airpocket-soundman/yashica8/img/yashica8T_PCB.png

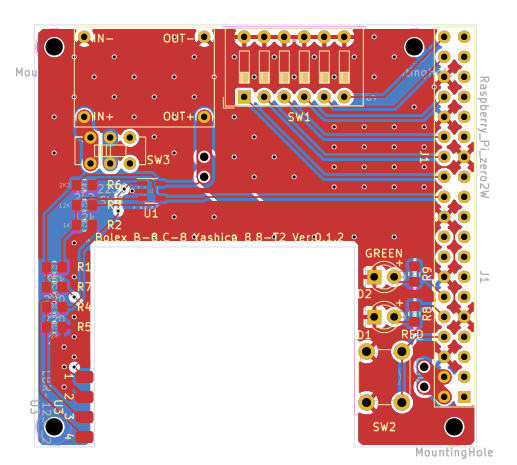
img/yashica8T_PCB.png
