airpocket-soundman/yashica8/img/yashica8T_schematic.png

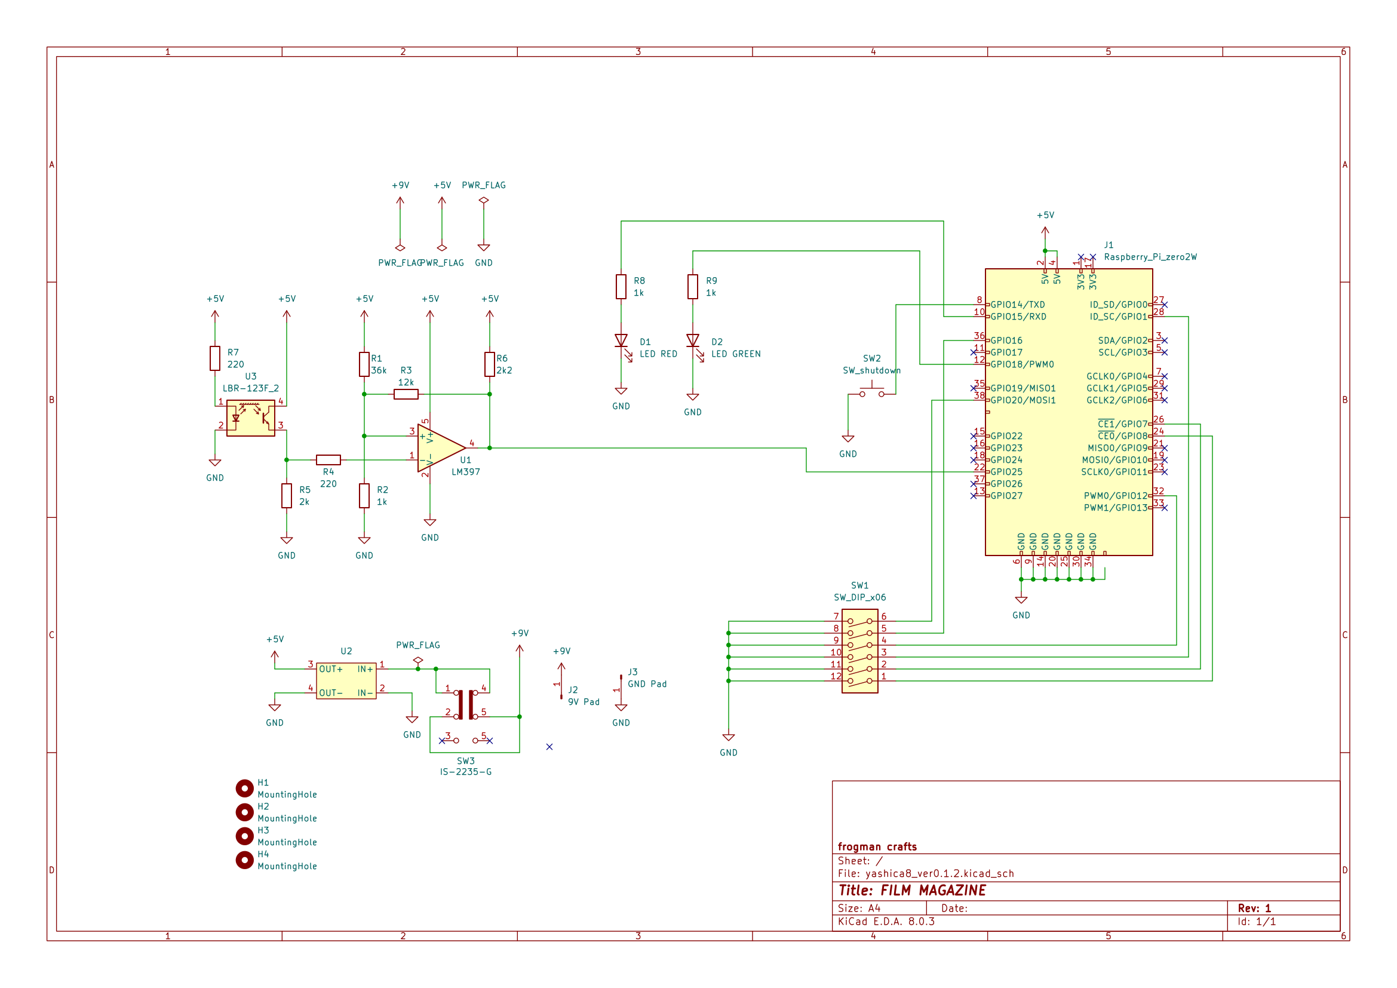
img/yashica8T_schematic.png
