airpocket-soundman/yashica8/stl/film_guide_yashica8 v12.stl

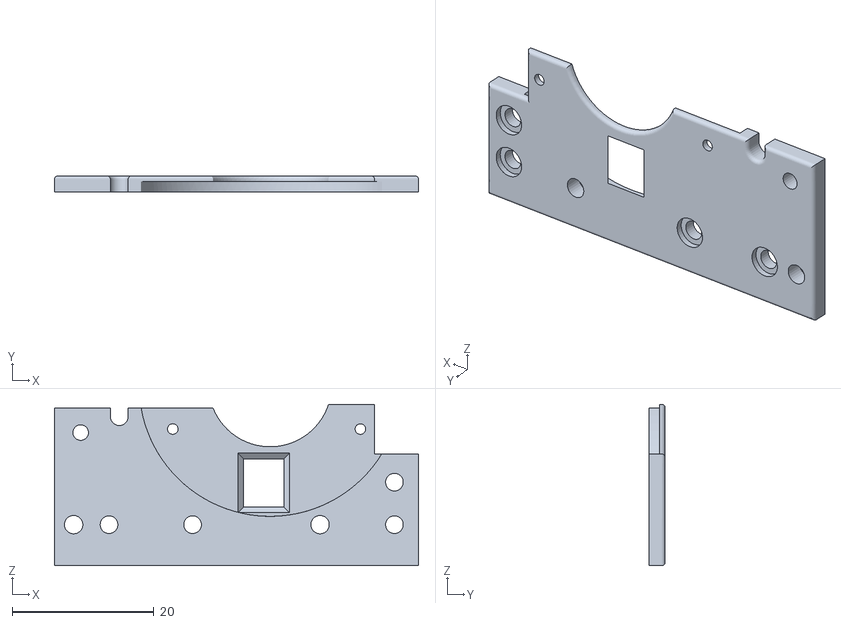
[picture p3: CAD file, 2024-09-23]
stl/film_guide_yashica8 v12.stl
51.4 x 2.30 x 22.8
