airpocket-soundman/yashica8/stl/floor_panel_yashica v19.stl

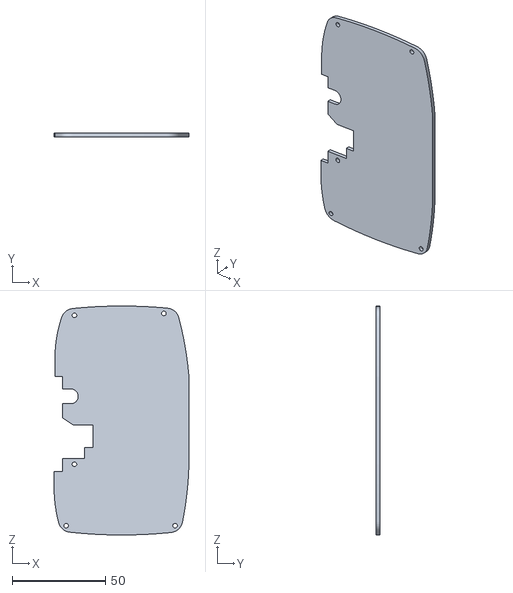
[picture p4: CAD file, 2024-09-23]
stl/floor_panel_yashica v19.stl
72.5 x 2.00 x 123.0
