airpocket-soundman/yashica8/stl/reflector_yashica8 v7.stl

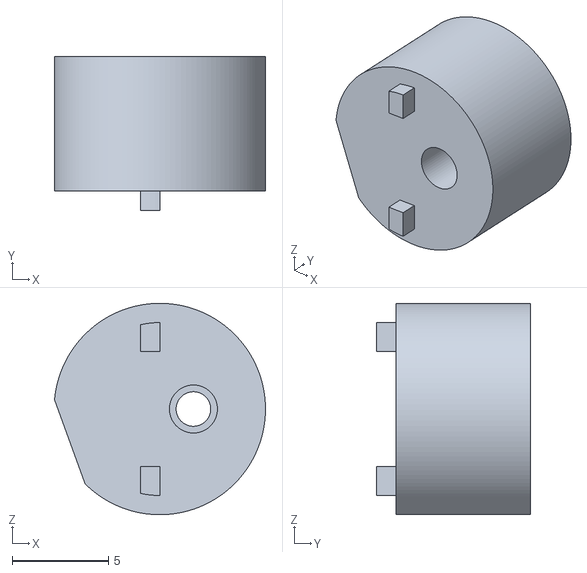
[picture p5: CAD file, 2024-09-23]
stl/reflector_yashica8 v7.stl
11.0 x 8.00 x 11.0
