airpocket-soundman/yashica8/stl/reflector_yashica8_T2 v8.stl

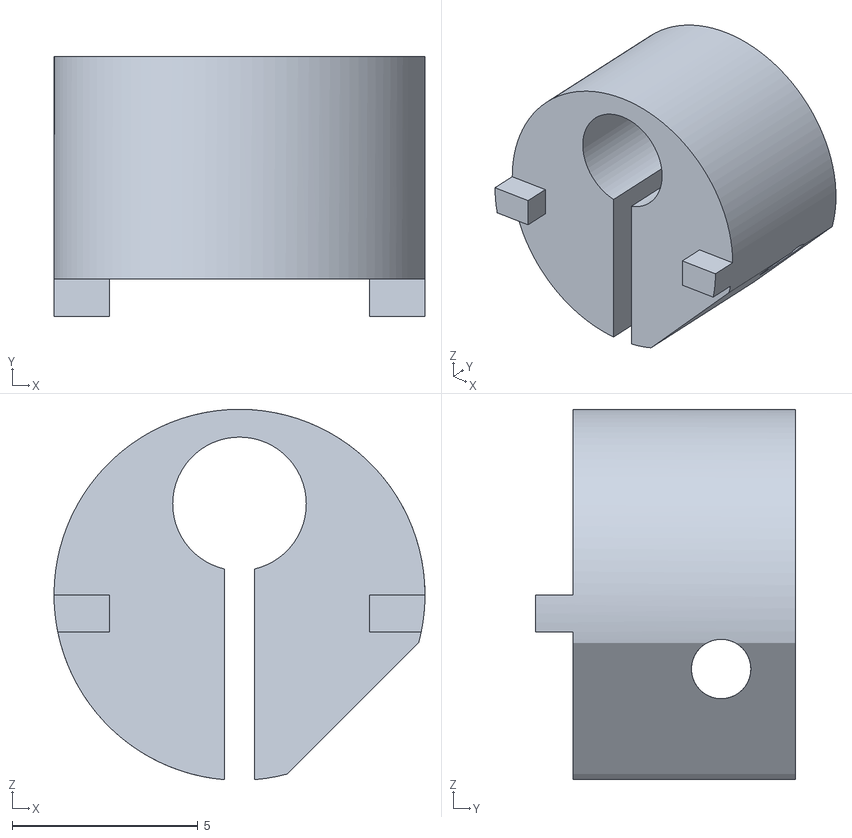
[picture p6: CAD file, 2024-09-23]
stl/reflector_yashica8_T2 v8.stl
10.0 x 7.00 x 9.98
