airpocket-soundman/yashica8/stl/base_pcb対応 v3.stl

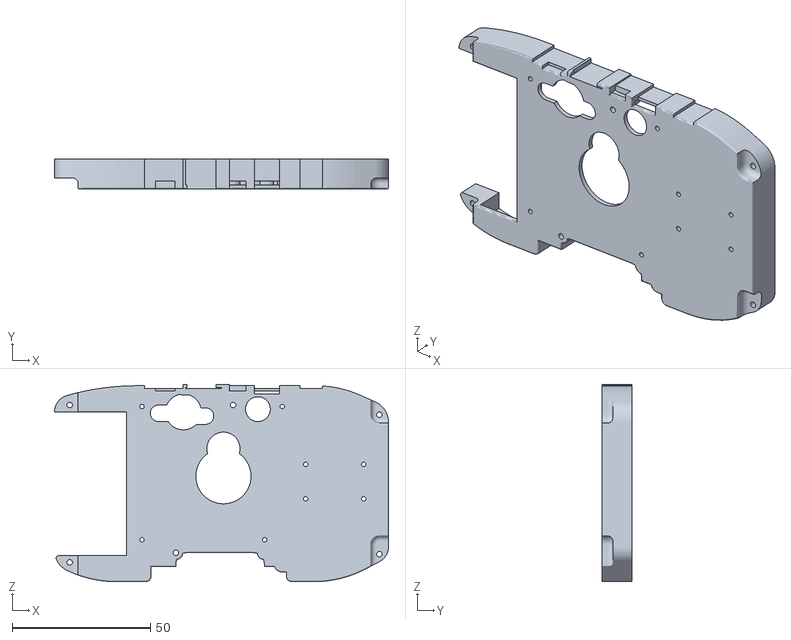
[picture p7: CAD file, 2024-09-23]
stl/base_pcb対応 v3.stl
121.0 x 11.0 x 71.5
