airpocket-soundman/yashica8/stl/top_pcb対応 v11.stl

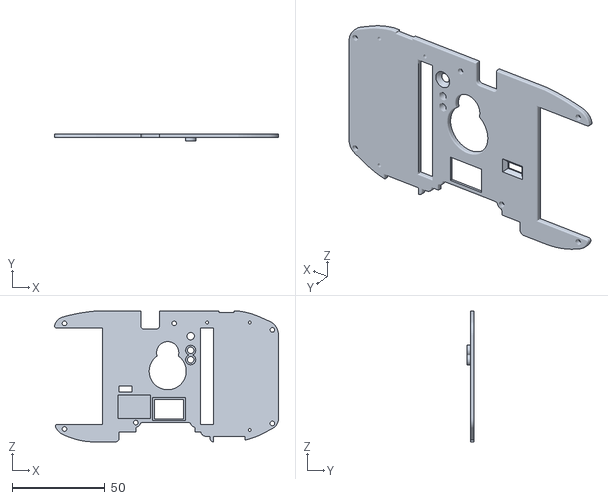
[picture p8: CAD file, 2024-09-23]
stl/top_pcb対応 v11.stl
120.9 x 4.00 x 70.7
