airpocket-soundman/yashica8/stl/film_guide_yashica8-T2 v3.stl

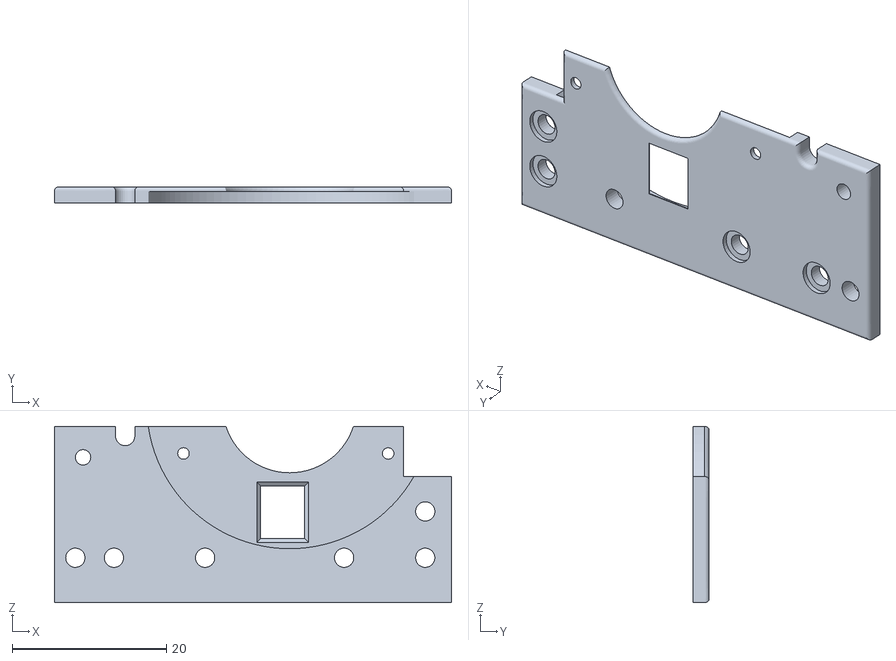
[picture p9: CAD file, 2024-09-23]
stl/film_guide_yashica8-T2 v3.stl
51.4 x 2.10 x 22.8
