airpocket-soundman/yashica8/img/yashica8T_schematic.pdf

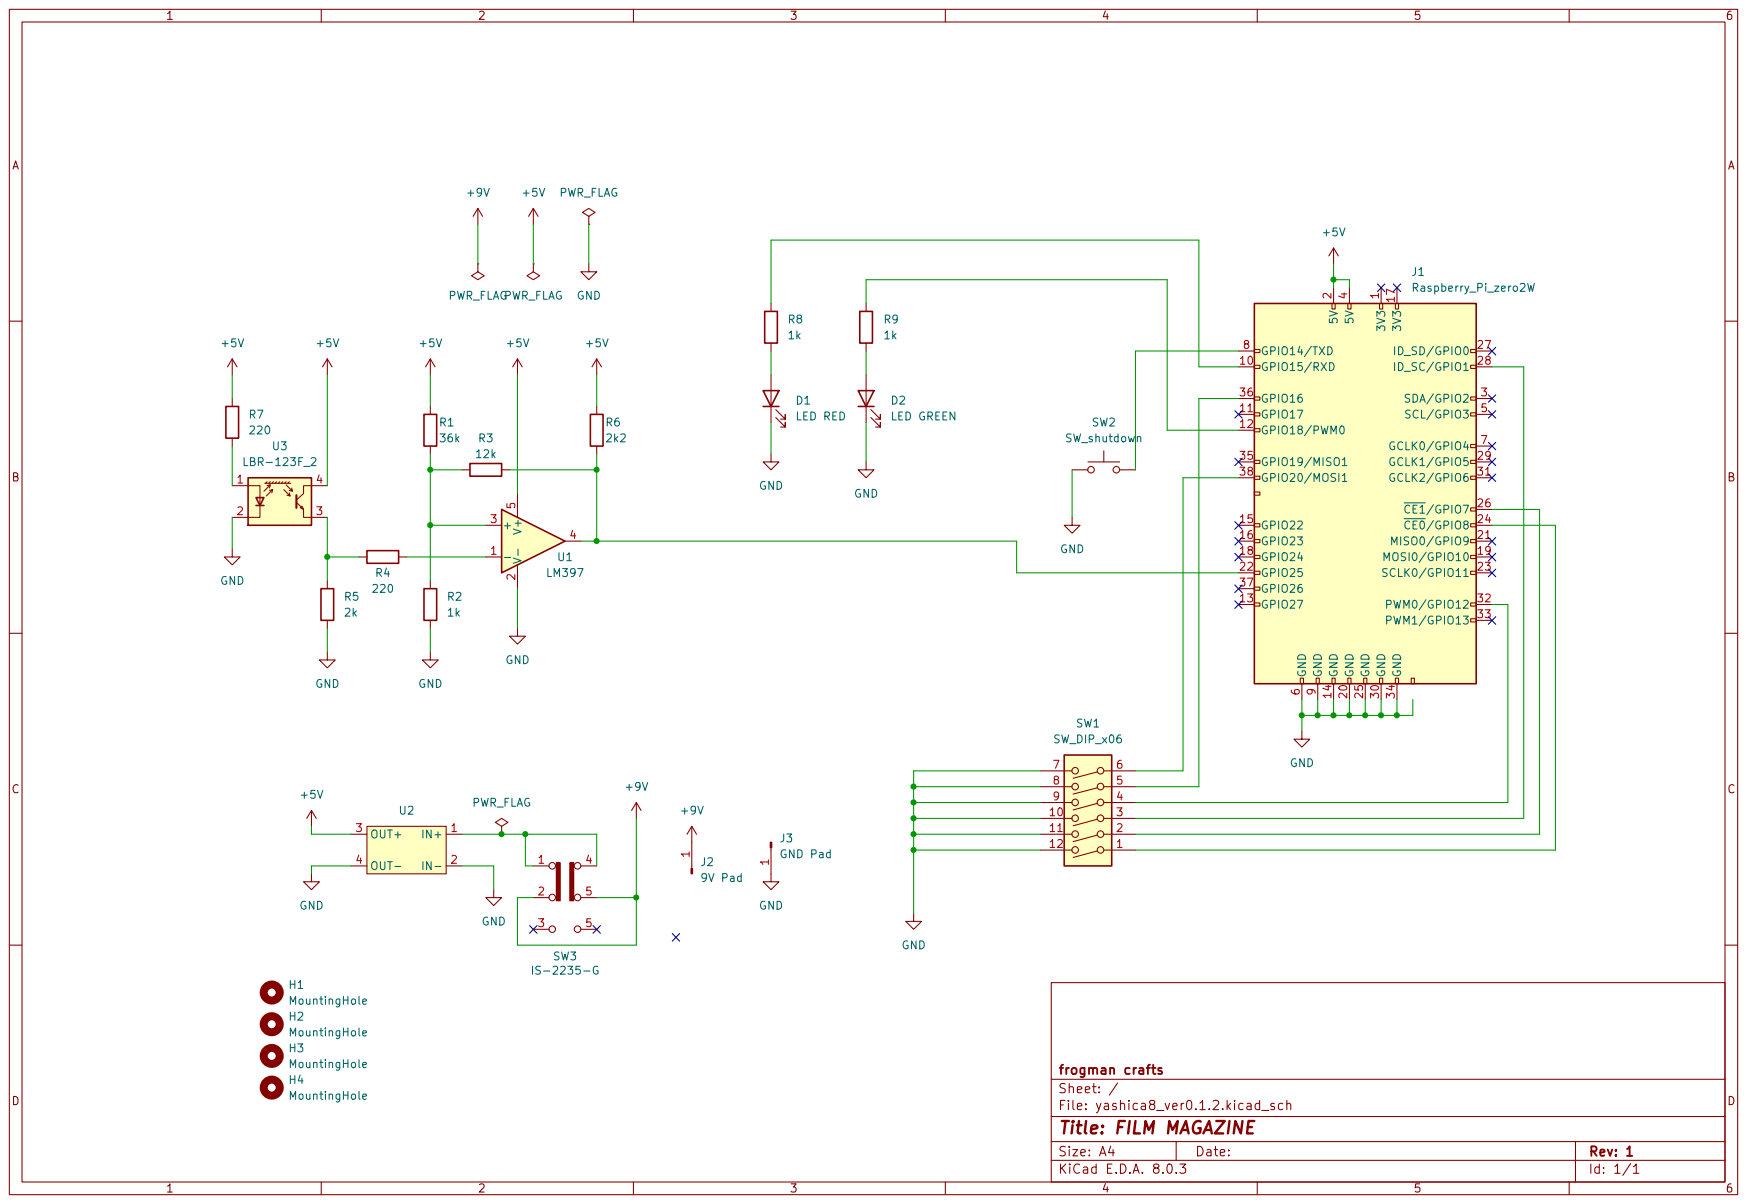
[picture p10: page 1]
