airpocket-soundman/yashica8/img/yashica8T_PCB.pdf

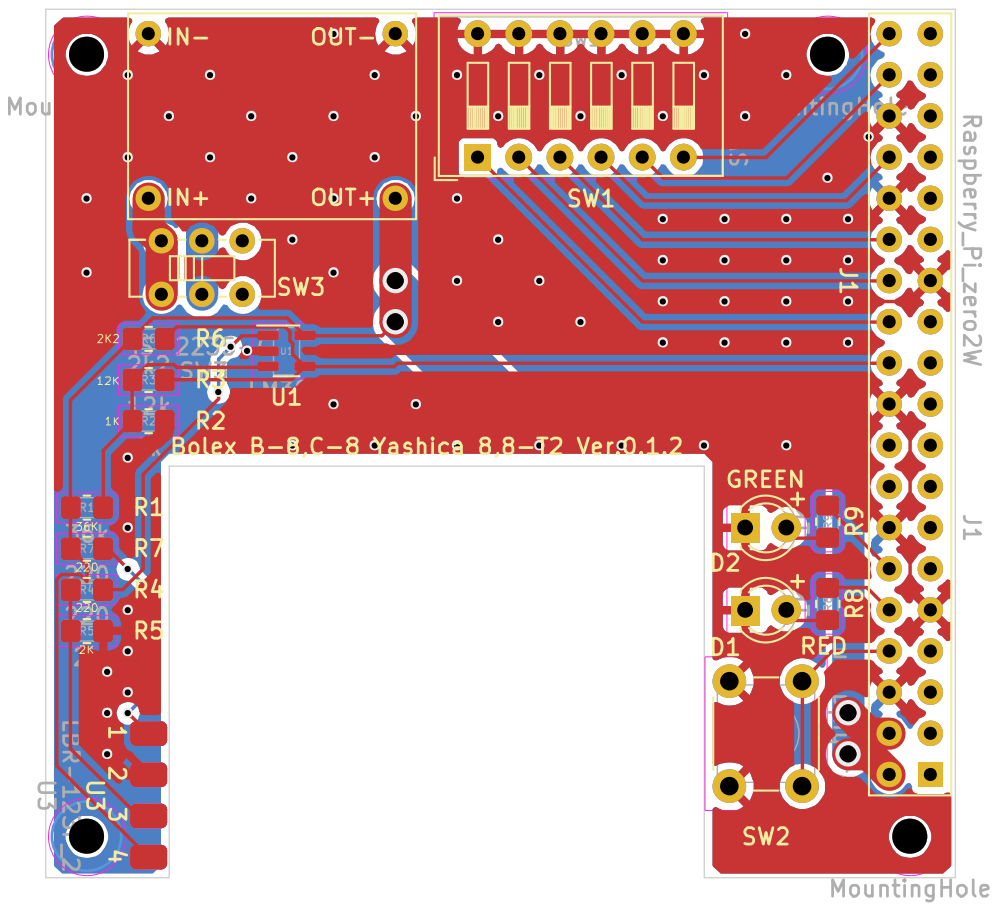
[picture p11: page 1]
