airpocket-soundman/yashica8/schematics/yashica8_ver0.1.2/yashica8_ver0.1.2.kicad_pcb

## KiCad design schematics/yashica8_ver0.1.2/yashica8_ver0.1.2.kicad_pcb (2024-09-23)

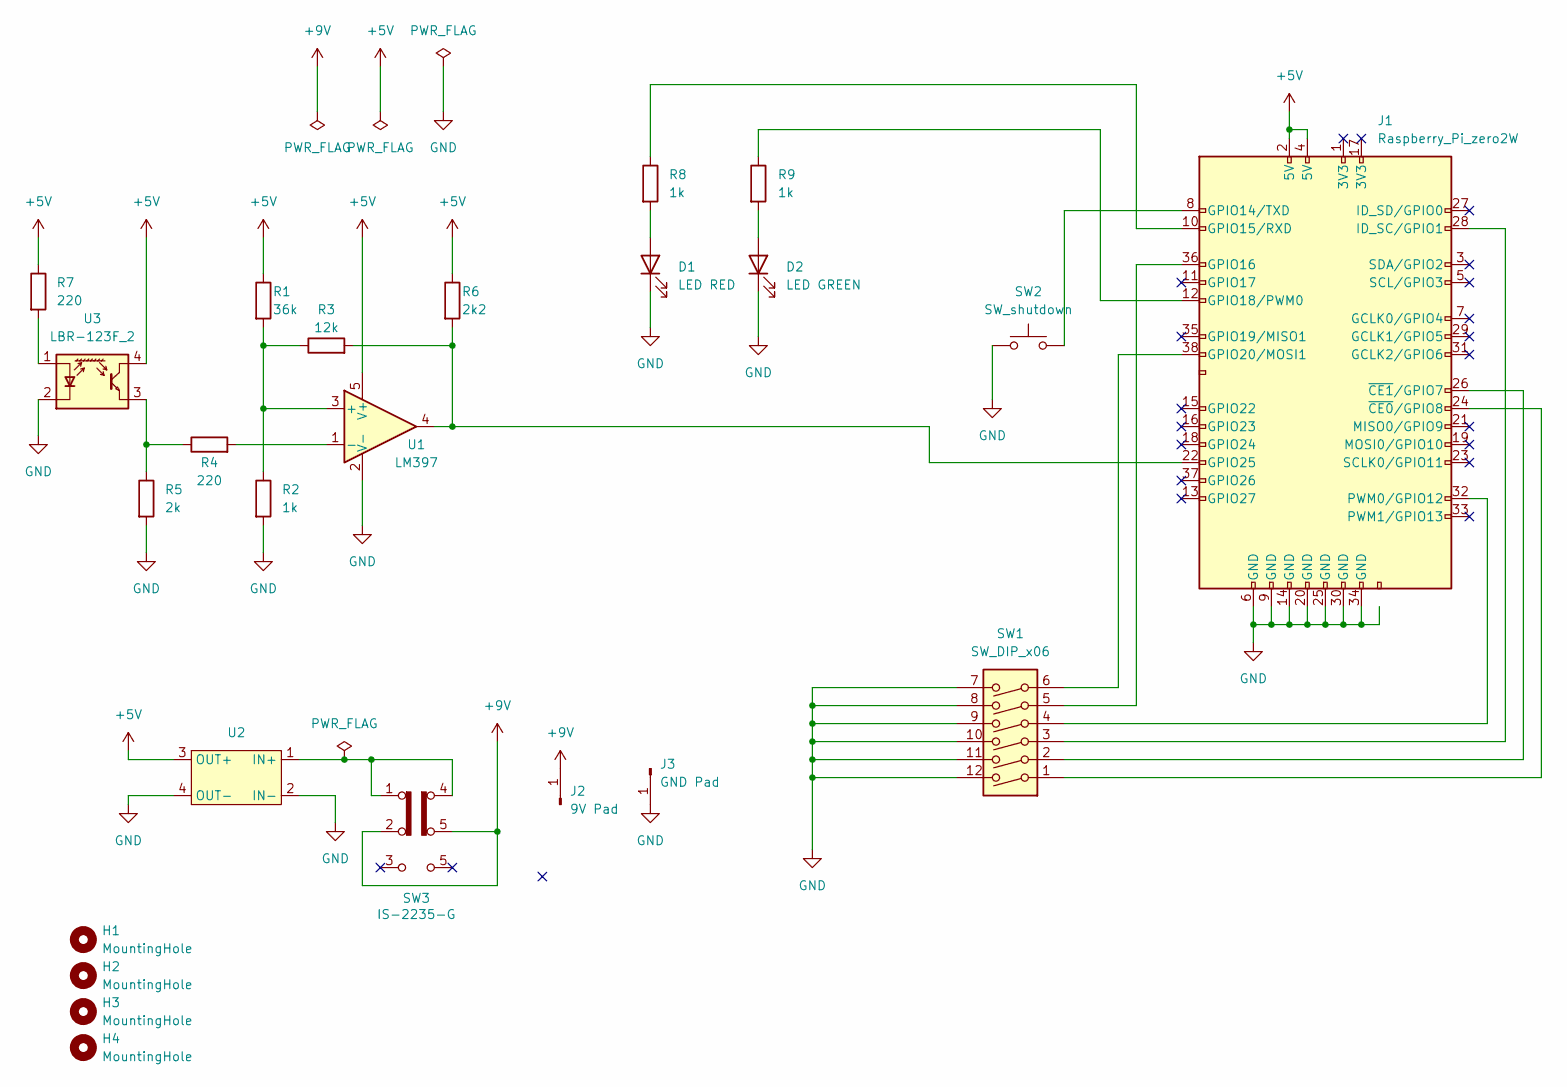
[picture p12: schematic yashica8_ver0.1.2.kicad_sch, FILM MAGAZINE]

Parts:
D1: LED RED; LED_D3.0mm
D2: LED GREEN; LED_D3.0mm
H1, H2, H3, H4: MountingHole; MountingHole_2.1mm
J1: Raspberry_Pi_zero2W; raspberry Pi socket 2x19
J2: 9V Pad; SolderWirePad_1x01_SMD_1x2mm
J3: GND Pad; SolderWirePad_1x01_SMD_1x2mm
R1: 36k; R_0805_2012Metric_Pad1.20x1.40mm_HandSolder
R2, R8, R9: 1k; R_0805_2012Metric_Pad1.20x1.40mm_HandSolder
R3: 12k; R_0805_2012Metric_Pad1.20x1.40mm_HandSolder
R4, R7: 220; R_0805_2012Metric_Pad1.20x1.40mm_HandSolder
R5: 2k; R_0805_2012Metric_Pad1.20x1.40mm_HandSolder
R6: 2k2; R_0805_2012Metric_Pad1.20x1.40mm_HandSolder
SW1: SW_DIP_x06; SW_DIP_SPSTx06_Slide_9.78x17.42mm_W7.62mm_P2.54mm
SW2: SW_shutdown; SW_PUSH_6mm
SW3: IS-2235-G
U1: LM397; SOT-23-5
U2: MP2307 DC-DC Board
U3: LBR-123F_2

Connections:
+5V: J1.2 (5V), J1.4 (5V), R1.1, R6.1, R7.1, U1.5 (V+), U2.3 (OUT+), U3.4
+9V: J2.1, SW3.2 (B), SW3.5 (B)
GND: D1.1 (K), D2.1 (K), J1.6 (GND), J1.9 (GND), J1.14 (GND), J1.20 (GND), J1.25 (GND), J1.30 (GND), J1.34 (GND), J3.1, R2.2, R5.2, SW1.7, SW1.8, SW1.9, SW1.10, SW1.11, SW1.12, SW2.1, U1.2 (V-), U2.2 (IN-), U2.4 (OUT-), U3.2 (K)
unnamed: D1.2 (A), R8.2
unnamed: D2.2 (A), R9.2
unnamed: J1.8 (GPIO14/TXD), SW2.2
unnamed: J1.10 (GPIO15/RXD), R8.1
unnamed: J1.36 (GPIO16), SW1.5
unnamed: J1.12 (GPIO18/PWM0), R9.1
unnamed: J1.38 (GPIO20/MOSI1), SW1.6
unnamed: J1.22 (GPIO25), R3.2, R6.2, U1.4
unnamed: J1.28 (ID_SC/GPIO1), SW1.3
unnamed: J1.32 (PWM0/GPIO12), SW1.4
unnamed: J1.24 (~CE0/GPIO8), SW1.1
unnamed: J1.26 (~CE1/GPIO7), SW1.2
unnamed: R4.1, R5.1, U3.3
unnamed: R1.2, R2.1, R3.1, U1.3 (+)
unnamed: R4.2, U1.1 (-)
unnamed: SW3.1 (A), SW3.4 (C), U2.1 (IN+)
unnamed: R7.2, U3.1 (A)

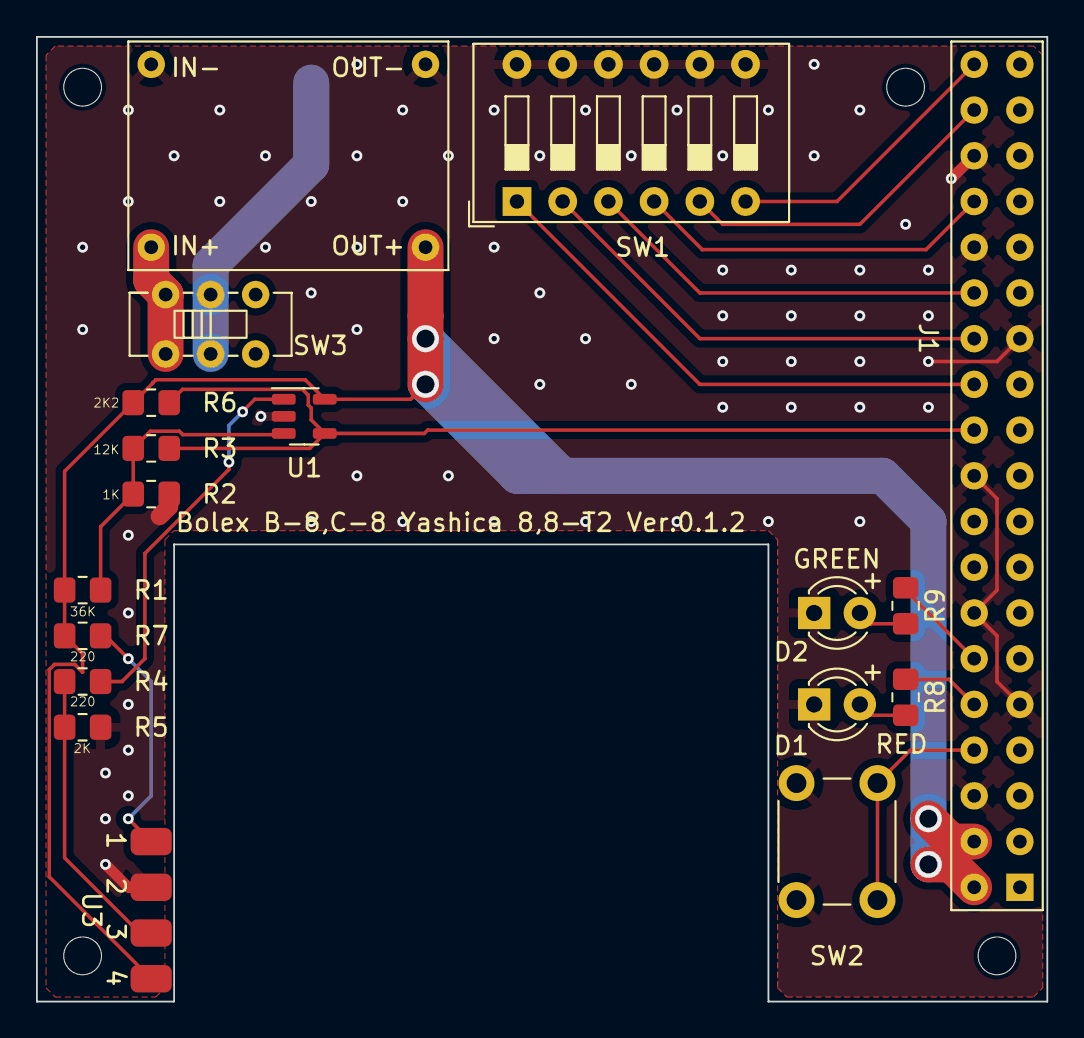
[picture p13: board yashica8_ver0.1.2.kicad_pcb from above]

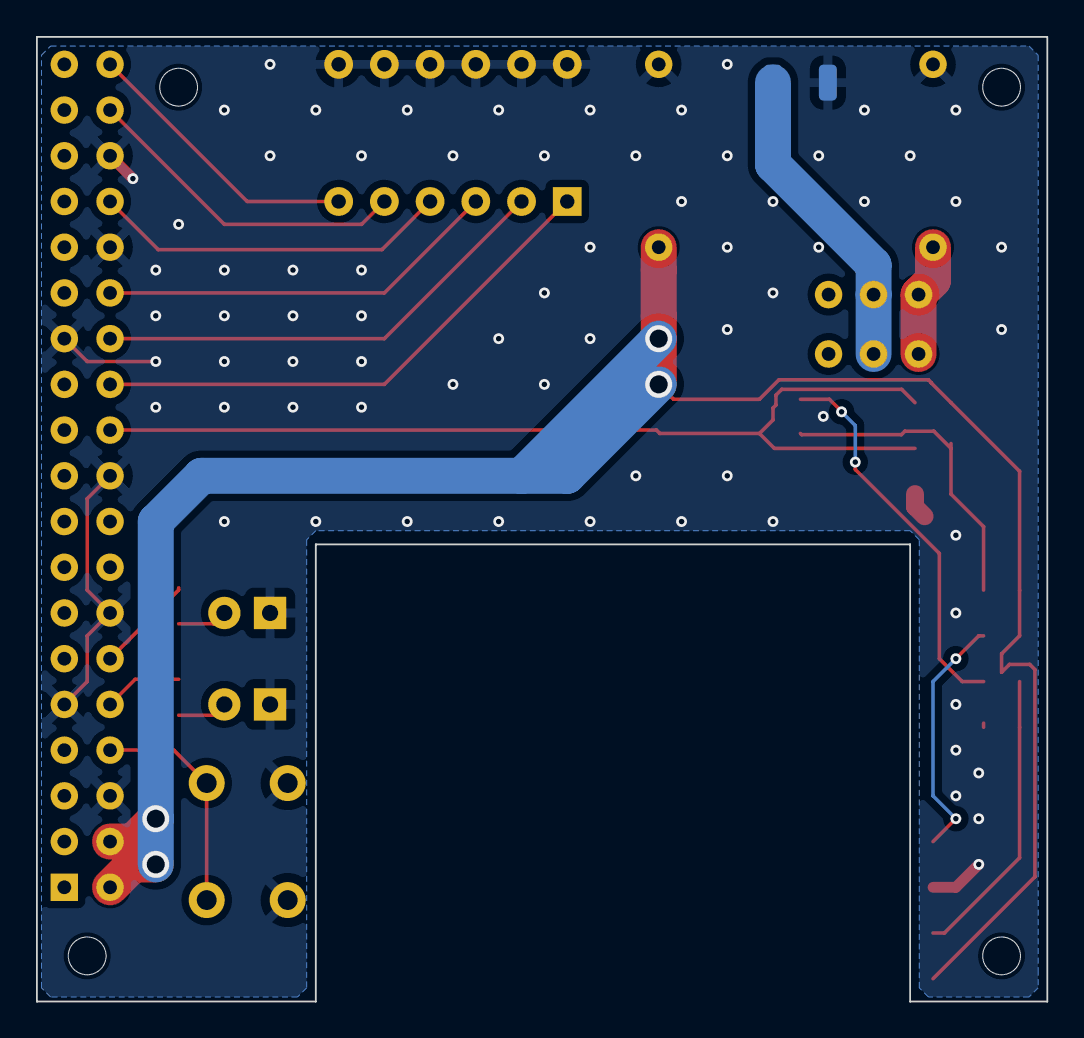
[picture p14: board yashica8_ver0.1.2.kicad_pcb from below]

Board: 2 copper layers, 56.1 x 53.6 mm, 24 parts (2 on the bottom side), 20 nets.
