airpocket-soundman/yashica8/(commit log)

2024-09-23 add stls
    [base_pcb対応 v3.stl, film_guide_yashica8 v12.stl, film_guide_yashica8-T2 v3.stl, floor_panel_yashica v19.stl, reflector_yashica8 v7.stl, reflector_yashica8_T2 v8.stl, top_pcb対応 v11.stl]
2024-09-23 add schematic
    [BOM-yashica8.csv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]
2026-05-20 add imx708 XVS sync project for 8mm telecine
    Yashica-8 のシャッター開放に IMX708 のフレーム読み出しを同期させる
    テレシネシステムの企画資料一式。
    - 0001-imx708-add-trigger-mode-XVS-sink.patch: IMX477 由来の
    trigger_mode (sink=2) を imx708.c に移植する差分
    - imx708_xvs_trigger_implementation.py: I2C レジスタ検証スクリプト
    と Zero 2W GPIO による XVS パルス生成コード
    - imx708_8mm_film_sync_report.md: 詳細検討報告 (HW構成・レジスタ仮定・
    ビルド手順・未解決課題)
